abhinavkumar346/Driver-Drowsiness-Detection-System/172505.png

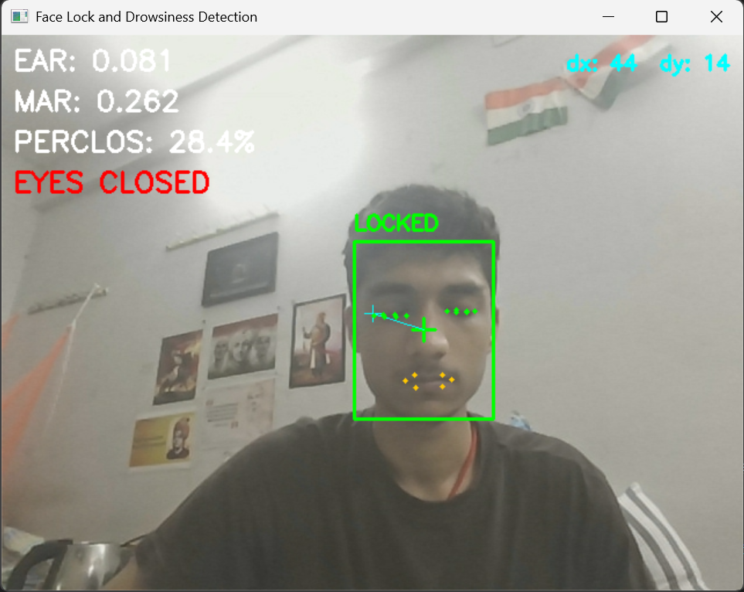
172505.png
