abhinavkumar346/Driver-Drowsiness-Detection-System/172518.png

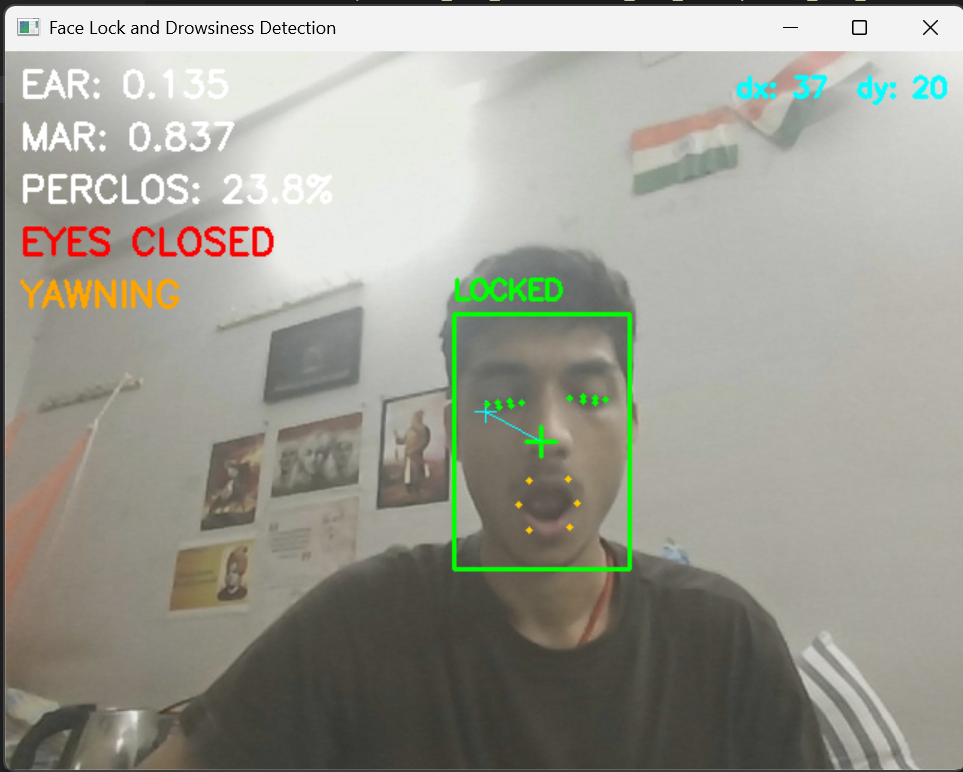
172518.png
