abhinavkumar346/Driver-Drowsiness-Detection-System/A.png

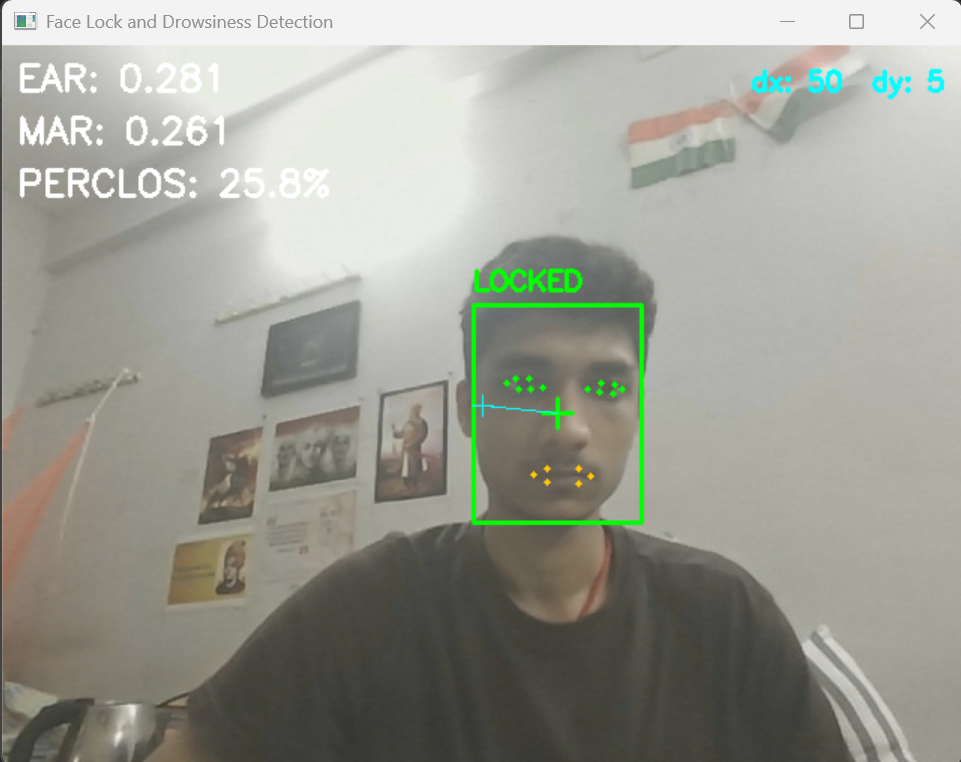
A.png
