abhinavkumar346/Driver-Drowsiness-Detection-System/Screenshot 2026-08-08 172554.png

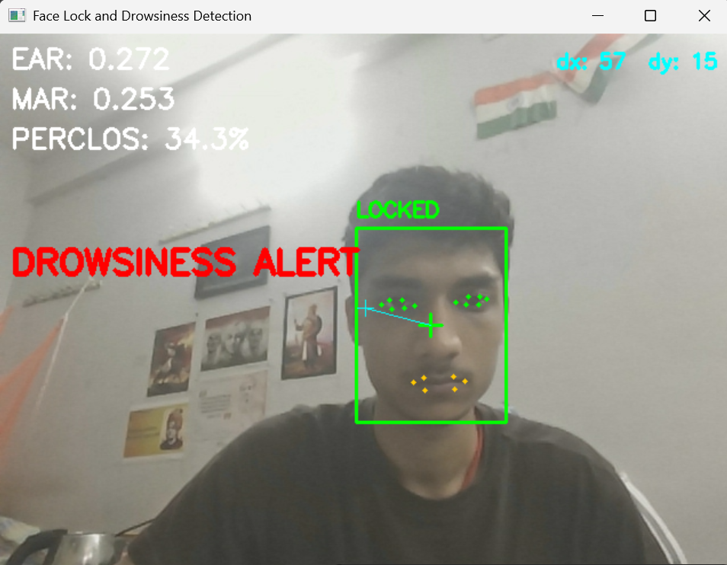
Screenshot 2026-08-08 172554.png
