abhinavkumar346/Driver-Drowsiness-Detection-System/(notices)

Notices in the files:
README.md:
License: MIT
